nosuz/PDP-8_IM6100/IM6100/IM6100.kicad_pcb

## KiCad design IM6100/IM6100.kicad_pcb (2025-11-16)

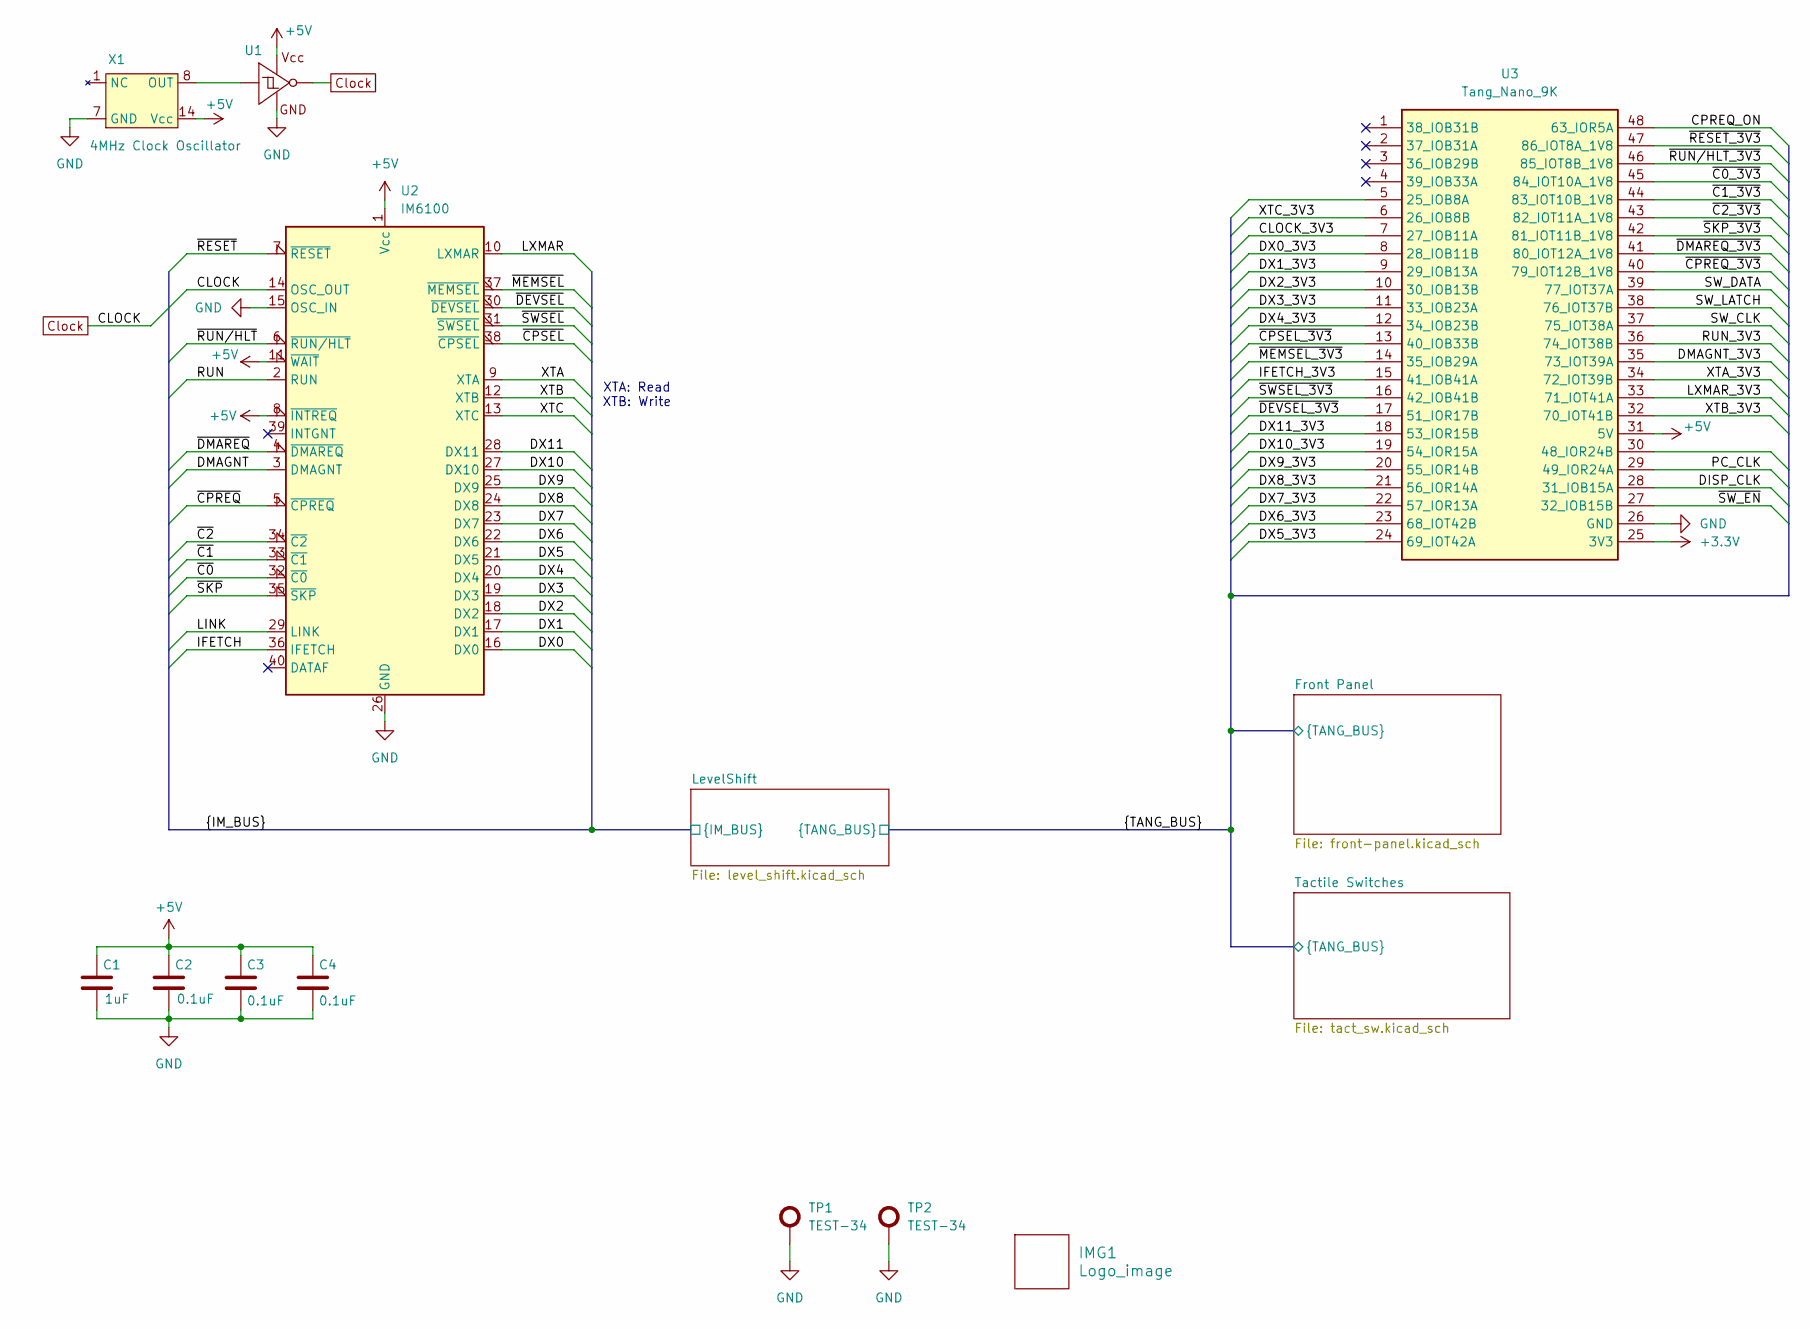
[picture p1: schematic IM6100.kicad_sch, PDP-8_IM6100]

Parts:
C1: 1uF; C_1608_0603; LCSC C15849
C2, C3, C4: 0.1uF; C_1608_0603; LCSC C14663
IMG1: Logo_image; Icon_Nosuz
TP1, TP2: TEST-34
U1: SN74AHCT1G14DBV; SOT-23-5_TI; LCSC C55250
U2: IM6100; DIP-40_IM6100
U3: Tang_Nano_9K; DIP-48_TangNano9K
X1: 4MHz Clock Oscillator; DIP-14_ClockOscillator

Connections:
+3.3V: U3.25 (3V3); also elsewhere on the board
+5V: C1.1, C2.1, C3.1, C4.1, U1.5 (Vcc), U2.1 (Vcc), U2.8 (~INTREQ), U2.11 (~WAIT), U3.31 (5V), X1.11 (Vcc), X1.14 (Vcc); also elsewhere on the board
/CLOCK_3V3: U3.7 (27_IOB11A); also elsewhere on the board
/CPREQ_ON: U3.48 (63_IOR5A); also elsewhere on the board
/DISP_CLK: U3.28 (31_IOB15A); also elsewhere on the board
/DMAGNT: U2.3 (DMAGNT); also elsewhere on the board
/DMAGNT_3V3: U3.35 (73_IOT39A); also elsewhere on the board
/DX0: U2.16 (DX0); also elsewhere on the board
/DX0_3V3: U3.8 (28_IOB11B); also elsewhere on the board
/DX1: U2.17 (DX1); also elsewhere on the board
/DX1_3V3: U3.9 (29_IOB13A); also elsewhere on the board
/DX2: U2.18 (DX2); also elsewhere on the board
/DX2_3V3: U3.10 (30_IOB13B); also elsewhere on the board
/DX3: U2.19 (DX3); also elsewhere on the board
/DX3_3V3: U3.11 (33_IOB23A); also elsewhere on the board
/DX4: U2.20 (DX4); also elsewhere on the board
/DX4_3V3: U3.12 (34_IOB23B); also elsewhere on the board
/DX5: U2.21 (DX5); also elsewhere on the board
/DX5_3V3: U3.24 (69_IOT42A); also elsewhere on the board
/DX6: U2.22 (DX6); also elsewhere on the board
/DX6_3V3: U3.23 (68_IOT42B); also elsewhere on the board
/DX7: U2.23 (DX7); also elsewhere on the board
/DX7_3V3: U3.22 (57_IOR13A); also elsewhere on the board
/DX8: U2.24 (DX8); also elsewhere on the board
/DX8_3V3: U3.21 (56_IOR14A); also elsewhere on the board
/DX9: U2.25 (DX9); also elsewhere on the board
/DX9_3V3: U3.20 (55_IOR14B); also elsewhere on the board
/DX10: U2.27 (DX10); also elsewhere on the board
/DX10_3V3: U3.19 (54_IOR15A); also elsewhere on the board
/DX11: U2.28 (DX11); also elsewhere on the board
/DX11_3V3: U3.18 (53_IOR15B); also elsewhere on the board
/IFETCH: U2.36 (IFETCH); also elsewhere on the board
/IFETCH_3V3: U3.15 (41_IOB41A); also elsewhere on the board
/LINK: U2.29 (LINK); also elsewhere on the board
/LXMAR: U2.10 (LXMAR); also elsewhere on the board
/LXMAR_3V3: U3.33 (71_IOT41A); also elsewhere on the board
/PC_CLK: U3.29 (49_IOR24A); also elsewhere on the board
/RUN: U2.2 (RUN); also elsewhere on the board
/RUN_3V3: U3.36 (74_IOT38B); also elsewhere on the board
/SW_CLK: U3.37 (75_IOT38A); also elsewhere on the board
/SW_DATA: U3.39 (77_IOT37A); also elsewhere on the board
/SW_LATCH: U3.38 (76_IOT37B); also elsewhere on the board
/XTA: U2.9 (XTA); also elsewhere on the board
/XTA_3V3: U3.34 (72_IOT39B); also elsewhere on the board
/XTB: U2.12 (XTB); also elsewhere on the board
/XTB_3V3: U3.32 (70_IOT41B); also elsewhere on the board
/XTC: U2.13 (XTC); also elsewhere on the board
/XTC_3V3: U3.6 (26_IOB8B); also elsewhere on the board
/~C0_3V3: U3.45 (84_IOT10A_1V8); also elsewhere on the board
/~C0: U2.32 (~C0); also elsewhere on the board
/~C1_3V3: U3.44 (83_IOT10B_1V8); also elsewhere on the board
/~C1: U2.33 (~C1); also elsewhere on the board
/~C2_3V3: U3.43 (82_IOT11A_1V8); also elsewhere on the board
/~C2: U2.34 (~C2); also elsewhere on the board
/~CPREQ_3V3: U3.40 (79_IOT12B_1V8); also elsewhere on the board
/~CPREQ: U2.5 (~CPREQ); also elsewhere on the board
/~CPSEL_3V3: U3.13 (40_IOB33B); also elsewhere on the board
/~CPSEL: U2.38 (~CPSEL); also elsewhere on the board
/~DEVSEL_3V3: U3.17 (51_IOR17B); also elsewhere on the board
/~DEVSEL: U2.30 (~DEVSEL); also elsewhere on the board
/~DMAREQ_3V3: U3.41 (80_IOT12A_1V8); also elsewhere on the board
/~DMAREQ: U2.4 (~DMAREQ); also elsewhere on the board
/~MEMSEL_3V3: U3.14 (35_IOB29A); also elsewhere on the board
/~MEMSEL: U2.37 (~MEMSEL); also elsewhere on the board
/~RESET_3V3: U3.47 (86_IOT8A_1V8); also elsewhere on the board
/~RESET: U2.7 (~RESET); also elsewhere on the board
/~RUN/HLT_3V3: U3.46 (85_IOT8B_1V8); also elsewhere on the board
/~RUN/HLT: U2.6 (~RUN/HLT); also elsewhere on the board
/~SKP_3V3: U3.42 (81_IOT11B_1V8); also elsewhere on the board
/~SKP: U2.35 (~SKP); also elsewhere on the board
/~SWSEL_3V3: U3.16 (42_IOB41B); also elsewhere on the board
/~SWSEL: U2.31 (~SWSEL); also elsewhere on the board
/~SW_EN: U3.27 (32_IOB15B); also elsewhere on the board
Clock: U1.4 (Y), U2.14 (OSC_OUT); also elsewhere on the board
GND: C1.2, C2.2, C3.2, C4.2, TP1.1 (Test), TP2.1 (Test), U1.3 (GND), U2.15 (OSC_IN), U2.26 (GND), U3.26 (GND), X1.2 (GND), X1.3 (GND), X1.5 (GND), X1.6 (GND), X1.7 (GND), X1.9 (GND), X1.10 (GND), X1.12 (GND), X1.13 (GND); also elsewhere on the board
unnamed: U1.2 (A), X1.8 (OUT)

Notes on the sheet:
XTA: Read XTB: Write

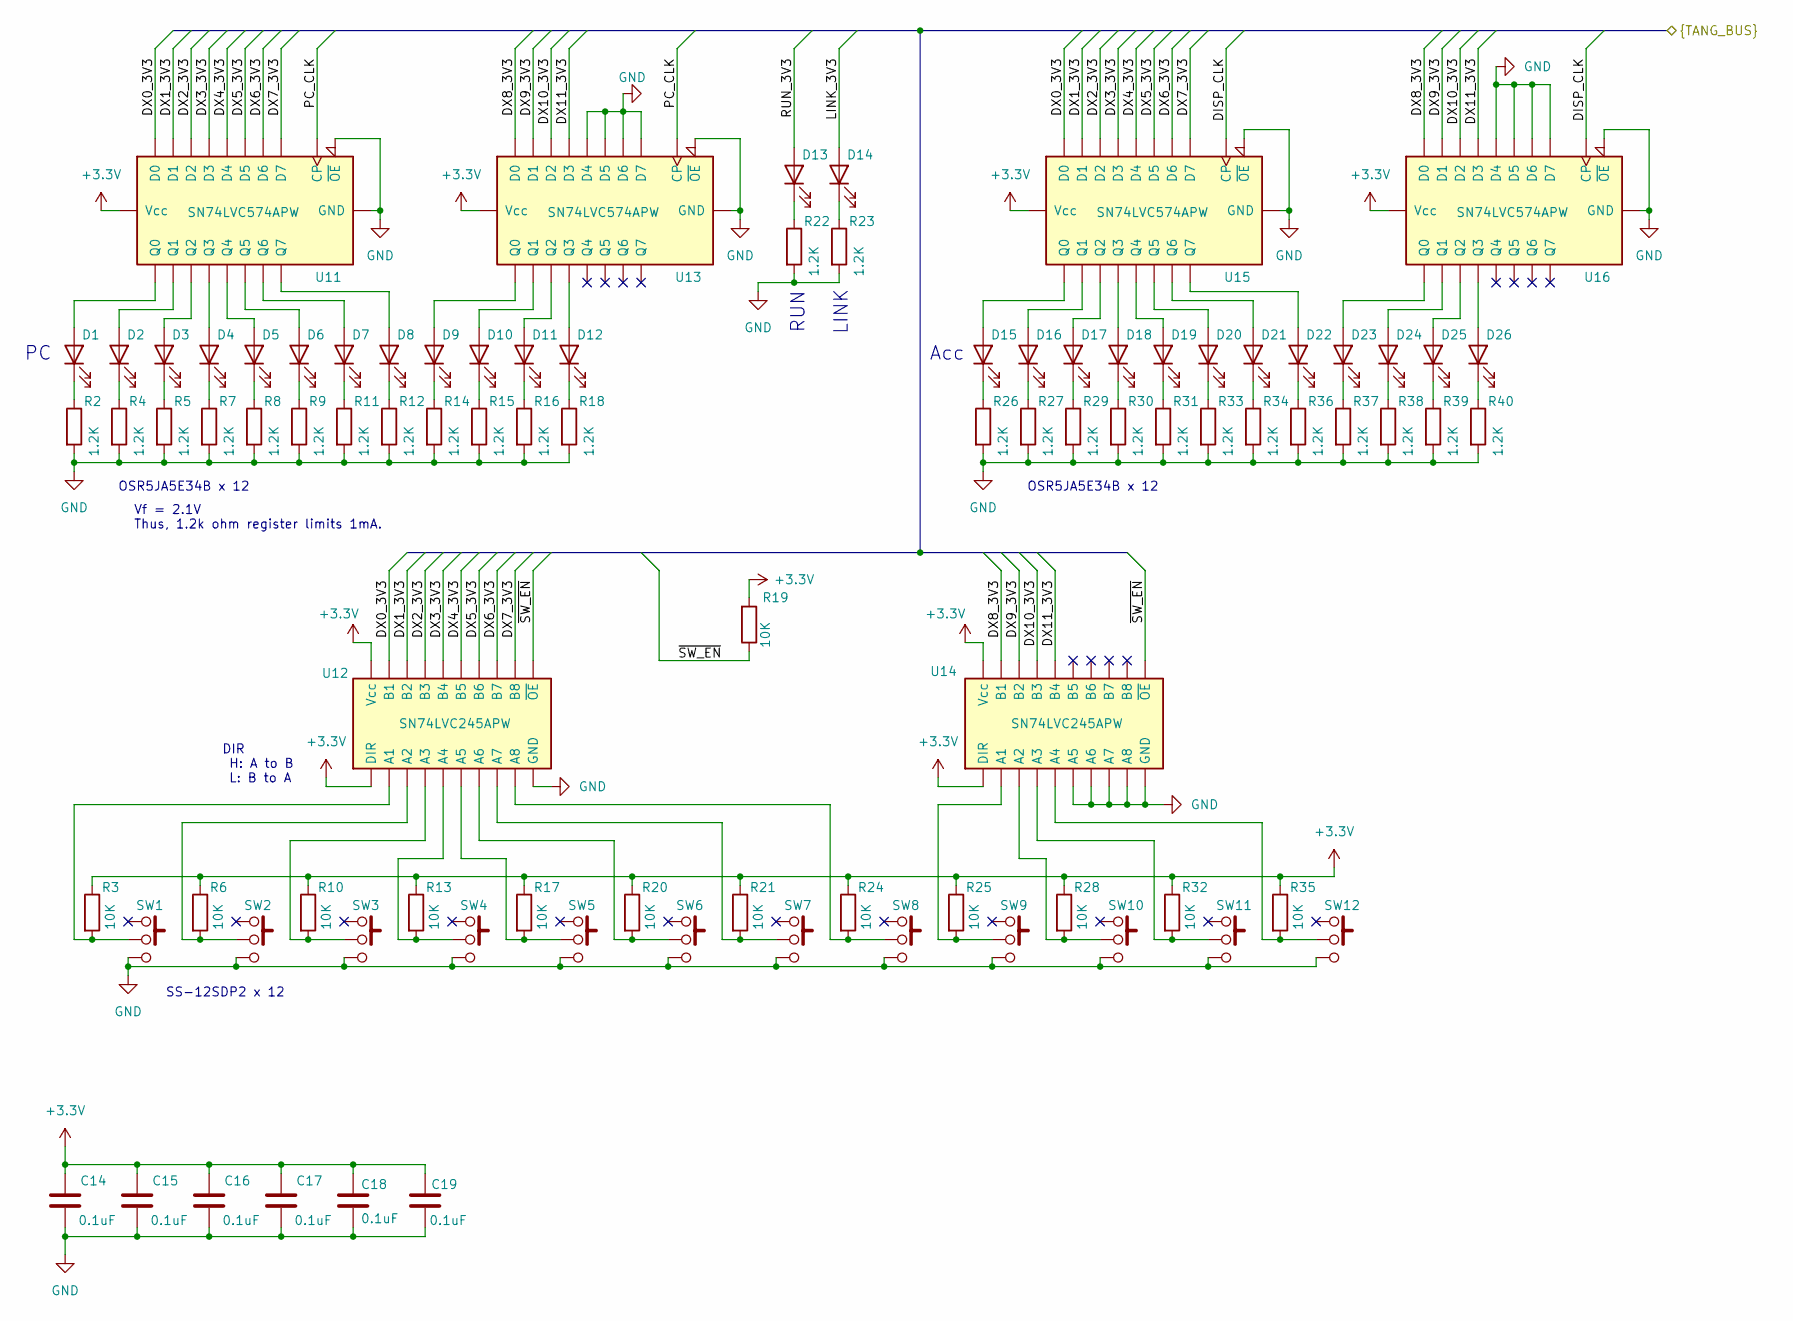
[picture p2: schematic front-panel.kicad_sch, PDP-8_IM6100]

Parts:
C14, C15, C16, C17, C18, C19: 0.1uF; C_1608_0603; LCSC C14663
D1, D2, D3, D4, D5, D6, D7, D8, D9, D10, D11, D12, D13, D14, D15, D16, D17, D18, D19, D20, D21, D22, D23, D24, D25, D26: OSR5JA5E34B; LED_5mm
R2, R4, R5, R7, R8, R9, R11, R12, R14, R15, R16, R18, R22, R23, R26, R27, R29, R30, R31, R33, R34, R36, R37, R38, R39, R40: 1.2K; R_1608_0603; LCSC C22765
R3, R6, R10, R13, R17, R19, R20, R21, R24, R25, R28, R32, R35: 10K; R_1608_0603; LCSC C25804
SW1, SW2, SW3, SW4, SW5, SW6, SW7, SW8, SW9, SW10, SW11, SW12: SS-12SDP2
U11, U13, U15, U16: SN74LVC574APW; TSSOP-20_TI-PW; LCSC C7672
U12, U14: SN74LVC245APW; TSSOP-20_TI-PW; LCSC C7848

Connections:
+3.3V: C14.1, C15.1, C16.1, C17.1, C18.1, C19.1, R3.1, R6.1, R10.1, R13.1, R17.1, R19.2, R20.1, R21.1, R24.1, R25.1, R28.1, R32.1, R35.1, U11.20 (Vcc), U12.1 (DIR), U12.20 (Vcc), U13.20 (Vcc), U14.1 (DIR), U14.20 (Vcc), U15.20 (Vcc), U16.20 (Vcc); also elsewhere on the board
/DISP_CLK: U15.11 (CP), U16.11 (CP); also elsewhere on the board
/DX0_3V3: U11.2 (D0), U12.18 (B1), U15.2 (D0); also elsewhere on the board
/DX1_3V3: U11.3 (D1), U12.17 (B2), U15.3 (D1); also elsewhere on the board
/DX2_3V3: U11.4 (D2), U12.16 (B3), U15.4 (D2); also elsewhere on the board
/DX3_3V3: U11.5 (D3), U12.15 (B4), U15.5 (D3); also elsewhere on the board
/DX4_3V3: U11.6 (D4), U12.14 (B5), U15.6 (D4); also elsewhere on the board
/DX5_3V3: U11.7 (D5), U12.13 (B6), U15.7 (D5); also elsewhere on the board
/DX6_3V3: U11.8 (D6), U12.12 (B7), U15.8 (D6); also elsewhere on the board
/DX7_3V3: U11.9 (D7), U12.11 (B8), U15.9 (D7); also elsewhere on the board
/DX8_3V3: U13.2 (D0), U14.18 (B1), U16.2 (D0); also elsewhere on the board
/DX9_3V3: U13.3 (D1), U14.17 (B2), U16.3 (D1); also elsewhere on the board
/DX10_3V3: U13.4 (D2), U14.16 (B3), U16.4 (D2); also elsewhere on the board
/DX11_3V3: U13.5 (D3), U14.15 (B4), U16.5 (D3); also elsewhere on the board
/LINK_3V3: D14.2 (A); also elsewhere on the board
/PC_CLK: U11.11 (CP), U13.11 (CP); also elsewhere on the board
/RUN_3V3: D13.2 (A); also elsewhere on the board
/~SW_EN: R19.1, U12.19 (~OE), U14.19 (~OE); also elsewhere on the board
GND: C14.2, C15.2, C16.2, C17.2, C18.2, C19.2, R2.2, R4.2, R5.2, R7.2, R8.2, R9.2, R11.2, R12.2, R14.2, R15.2, R16.2, R18.2, R22.2, R23.2, R26.2, R27.2, R29.2, R30.2, R31.2, R33.2, R34.2, R36.2, R37.2, R38.2, R39.2, R40.2, SW1.1, SW2.1, SW3.1, SW4.1, SW5.1, SW6.1, SW7.1, SW8.1, SW9.1, SW10.1, SW11.1, SW12.1, U11.1 (~OE), U11.10 (GND), U12.10 (GND), U13.1 (~OE), U13.6 (D4), U13.7 (D5), U13.8 (D6), U13.9 (D7), U13.10 (GND), U14.6 (A5), U14.7 (A6), U14.8 (A7), U14.9 (A8), U14.10 (GND), U15.1 (~OE), U15.10 (GND), U16.1 (~OE), U16.6 (D4), U16.7 (D5), U16.8 (D6), U16.9 (D7), U16.10 (GND); also elsewhere on the board
unnamed: D1.2 (A), U11.19 (Q0)
unnamed: D1.1 (K), R2.1
unnamed: D2.2 (A), U11.18 (Q1)
unnamed: D2.1 (K), R4.1
unnamed: D3.2 (A), U11.17 (Q2)
unnamed: D3.1 (K), R5.1
unnamed: D4.2 (A), U11.16 (Q3)
unnamed: D4.1 (K), R7.1
unnamed: D5.2 (A), U11.15 (Q4)
unnamed: D5.1 (K), R8.1
unnamed: D6.2 (A), U11.14 (Q5)
unnamed: D6.1 (K), R9.1
unnamed: D7.2 (A), U11.13 (Q6)
unnamed: D7.1 (K), R11.1
unnamed: D8.2 (A), U11.12 (Q7)
unnamed: D8.1 (K), R12.1
unnamed: D9.2 (A), U13.19 (Q0)
unnamed: D9.1 (K), R14.1
unnamed: D10.2 (A), U13.18 (Q1)
unnamed: D10.1 (K), R15.1
unnamed: D11.2 (A), U13.17 (Q2)
unnamed: D11.1 (K), R16.1
unnamed: D12.2 (A), U13.16 (Q3)
unnamed: D12.1 (K), R18.1
unnamed: D13.1 (K), R22.1
unnamed: D14.1 (K), R23.1
unnamed: D15.2 (A), U15.19 (Q0)
unnamed: D15.1 (K), R26.1
unnamed: D16.2 (A), U15.18 (Q1)
unnamed: D16.1 (K), R27.1
unnamed: D17.2 (A), U15.17 (Q2)
unnamed: D17.1 (K), R29.1
unnamed: D18.2 (A), U15.16 (Q3)
unnamed: D18.1 (K), R30.1
unnamed: D19.2 (A), U15.15 (Q4)
unnamed: D19.1 (K), R31.1
unnamed: D20.2 (A), U15.14 (Q5)
unnamed: D20.1 (K), R33.1
unnamed: D21.2 (A), U15.13 (Q6)
unnamed: D21.1 (K), R34.1
unnamed: D22.2 (A), U15.12 (Q7)
unnamed: D22.1 (K), R36.1
unnamed: D23.2 (A), U16.19 (Q0)
unnamed: D23.1 (K), R37.1
unnamed: D24.2 (A), U16.18 (Q1)
unnamed: D24.1 (K), R38.1
unnamed: D25.2 (A), U16.17 (Q2)
unnamed: D25.1 (K), R39.1
unnamed: D26.2 (A), U16.16 (Q3)
unnamed: D26.1 (K), R40.1
unnamed: R3.2, SW1.2, U12.2 (A1)
unnamed: R6.2, SW2.2, U12.3 (A2)
unnamed: R10.2, SW3.2, U12.4 (A3)
unnamed: R13.2, SW4.2, U12.5 (A4)
unnamed: R17.2, SW5.2, U12.6 (A5)
unnamed: R20.2, SW6.2, U12.7 (A6)
unnamed: R21.2, SW7.2, U12.8 (A7)
unnamed: R24.2, SW8.2, U12.9 (A8)
unnamed: R25.2, SW9.2, U14.2 (A1)
unnamed: R28.2, SW10.2, U14.3 (A2)
unnamed: R32.2, SW11.2, U14.4 (A3)
unnamed: R35.2, SW12.2, U14.5 (A4)

Notes on the sheet:
OSR5JA5E34B x 12
SS-12SDP2 x 12
Vf = 2.1V Thus, 1.2k ohm register limits 1mA.
LINK
DIR H: A to B L: B to A
RUN
Acc

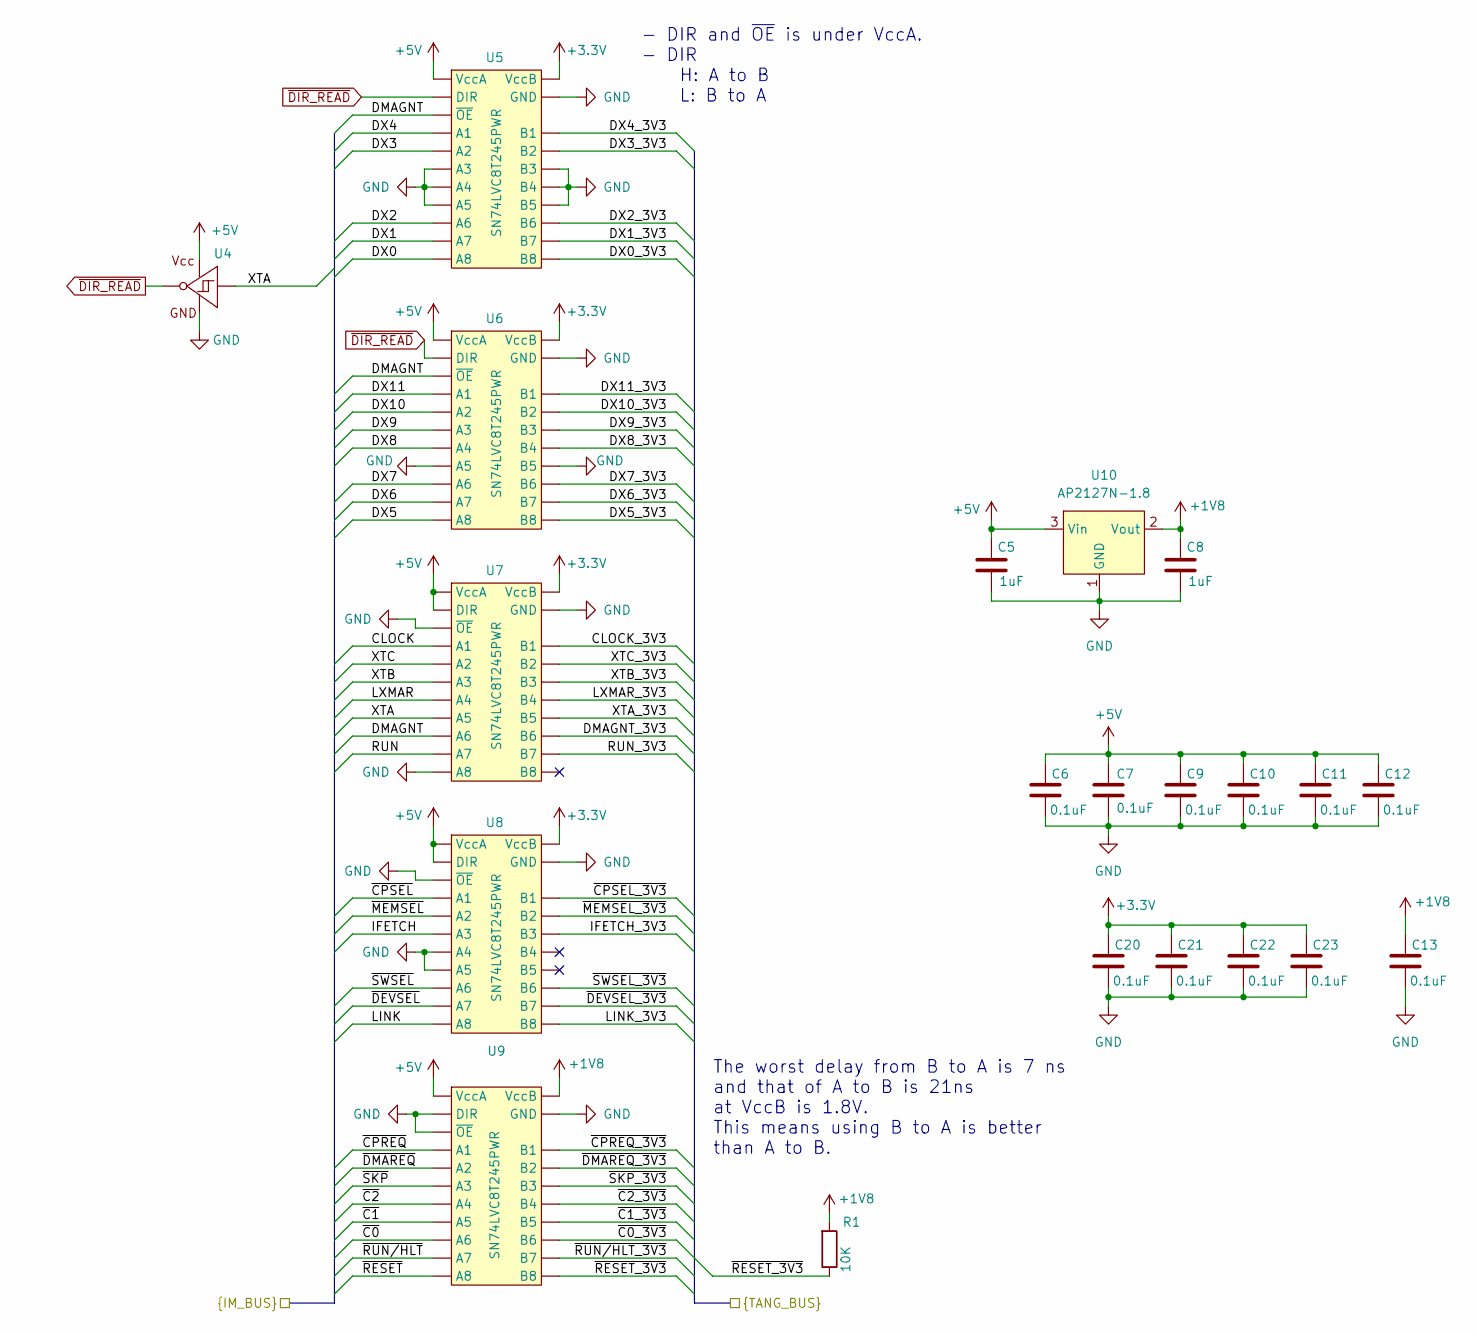
[picture p3: schematic level_shift.kicad_sch, PDP-8_IM6100]

Parts:
C5, C8: 1uF; C_1608_0603; LCSC C15849
C6, C7, C9, C10, C11, C12, C13, C20, C21, C22, C23: 0.1uF; C_1608_0603; LCSC C14663
R1: 10K; R_1608_0603; LCSC C25804
U4: SN74AHCT1G14DBV; SOT-23-5_TI; LCSC C55250
U5, U6, U7, U8, U9: SN74LVC8T245PWR; TSSOP-24_TI-PW; LCSC C27643
U10: AP2127N-1.8; SOT-23_AP2127N; LCSC C780749

Connections:
+1V8: C8.1, C13.1, R1.2, U9.23 (VccB), U9.24 (VccB), U10.2 (Vout)
+3.3V: C20.1, C21.1, C22.1, C23.1, U5.23 (VccB), U5.24 (VccB), U6.23 (VccB), U6.24 (VccB), U7.23 (VccB), U7.24 (VccB), U8.23 (VccB), U8.24 (VccB); also elsewhere on the board
+5V: C5.1, C6.1, C7.1, C9.1, C10.1, C11.1, C12.1, U4.5 (Vcc), U5.1 (VccA), U6.1 (VccA), U7.1 (VccA), U7.2 (DIR), U8.1 (VccA), U8.2 (DIR), U9.1 (VccA), U10.3 (Vin); also elsewhere on the board
/CLOCK_3V3: U7.21 (B1); also elsewhere on the board
/DMAGNT: U5.22 (~OE), U6.22 (~OE), U7.8 (A6); also elsewhere on the board
/DMAGNT_3V3: U7.16 (B6); also elsewhere on the board
/DX0: U5.10 (A8); also elsewhere on the board
/DX0_3V3: U5.14 (B8); also elsewhere on the board
/DX1: U5.9 (A7); also elsewhere on the board
/DX1_3V3: U5.15 (B7); also elsewhere on the board
/DX2: U5.8 (A6); also elsewhere on the board
/DX2_3V3: U5.16 (B6); also elsewhere on the board
/DX3: U5.4 (A2); also elsewhere on the board
/DX3_3V3: U5.20 (B2); also elsewhere on the board
/DX4: U5.3 (A1); also elsewhere on the board
/DX4_3V3: U5.21 (B1); also elsewhere on the board
/DX5: U6.10 (A8); also elsewhere on the board
/DX5_3V3: U6.14 (B8); also elsewhere on the board
/DX6: U6.9 (A7); also elsewhere on the board
/DX6_3V3: U6.15 (B7); also elsewhere on the board
/DX7: U6.8 (A6); also elsewhere on the board
/DX7_3V3: U6.16 (B6); also elsewhere on the board
/DX8: U6.6 (A4); also elsewhere on the board
/DX8_3V3: U6.18 (B4); also elsewhere on the board
/DX9: U6.5 (A3); also elsewhere on the board
/DX9_3V3: U6.19 (B3); also elsewhere on the board
/DX10: U6.4 (A2); also elsewhere on the board
/DX10_3V3: U6.20 (B2); also elsewhere on the board
/DX11: U6.3 (A1); also elsewhere on the board
/DX11_3V3: U6.21 (B1); also elsewhere on the board
/IFETCH: U8.5 (A3); also elsewhere on the board
/IFETCH_3V3: U8.19 (B3); also elsewhere on the board
/LINK: U8.10 (A8); also elsewhere on the board
/LINK_3V3: U8.14 (B8); also elsewhere on the board
/LXMAR: U7.6 (A4); also elsewhere on the board
/LXMAR_3V3: U7.18 (B4); also elsewhere on the board
/RUN: U7.9 (A7); also elsewhere on the board
/RUN_3V3: U7.15 (B7); also elsewhere on the board
/XTA: U4.2 (A), U7.7 (A5); also elsewhere on the board
/XTA_3V3: U7.17 (B5); also elsewhere on the board
/XTB: U7.5 (A3); also elsewhere on the board
/XTB_3V3: U7.19 (B3); also elsewhere on the board
/XTC: U7.4 (A2); also elsewhere on the board
/XTC_3V3: U7.20 (B2); also elsewhere on the board
/~C0_3V3: U9.16 (B6); also elsewhere on the board
/~C0: U9.8 (A6); also elsewhere on the board
/~C1_3V3: U9.17 (B5); also elsewhere on the board
/~C1: U9.7 (A5); also elsewhere on the board
/~C2_3V3: U9.18 (B4); also elsewhere on the board
/~C2: U9.6 (A4); also elsewhere on the board
/~CPREQ_3V3: U9.21 (B1); also elsewhere on the board
/~CPREQ: U9.3 (A1); also elsewhere on the board
/~CPSEL_3V3: U8.21 (B1); also elsewhere on the board
/~CPSEL: U8.3 (A1); also elsewhere on the board
/~DEVSEL_3V3: U8.15 (B7); also elsewhere on the board
/~DEVSEL: U8.9 (A7); also elsewhere on the board
/~DMAREQ_3V3: U9.20 (B2); also elsewhere on the board
/~DMAREQ: U9.4 (A2); also elsewhere on the board
/~MEMSEL_3V3: U8.20 (B2); also elsewhere on the board
/~MEMSEL: U8.4 (A2); also elsewhere on the board
/~RESET_3V3: R1.1, U9.14 (B8); also elsewhere on the board
/~RESET: U9.10 (A8); also elsewhere on the board
/~RUN/HLT_3V3: U9.15 (B7); also elsewhere on the board
/~RUN/HLT: U9.9 (A7); also elsewhere on the board
/~SKP_3V3: U9.19 (B3); also elsewhere on the board
/~SKP: U9.5 (A3); also elsewhere on the board
/~SWSEL_3V3: U8.16 (B6); also elsewhere on the board
/~SWSEL: U8.8 (A6); also elsewhere on the board
Clock: U7.3 (A1); also elsewhere on the board
GND: C5.2, C6.2, C7.2, C8.2, C9.2, C10.2, C11.2, C12.2, C13.2, C20.2, C21.2, C22.2, C23.2, U4.3 (GND), U5.5 (A3), U5.6 (A4), U5.7 (A5), U5.11 (GND), U5.12 (GND), U5.13 (GND), U5.17 (B5), U5.18 (B4), U5.19 (B3), U6.7 (A5), U6.11 (GND), U6.12 (GND), U6.13 (GND), U6.17 (B5), U7.10 (A8), U7.11 (GND), U7.12 (GND), U7.13 (GND), U7.22 (~OE), U8.6 (A4), U8.7 (A5), U8.11 (GND), U8.12 (GND), U8.13 (GND), U8.22 (~OE), U9.2 (DIR), U9.11 (GND), U9.12 (GND), U9.13 (GND), U9.22 (~OE), U10.1 (GND); also elsewhere on the board
~DIR_READ: U4.4 (Y), U5.2 (DIR), U6.2 (DIR)

Notes on the sheet:
The worst delay from B to A is 7 ns and that of A to B is 21ns at VccB is 1.8V. This means using B to A is better than A to B.
- DIR and ~{OE} is under VccA. - DIR H: A to B L: B to A

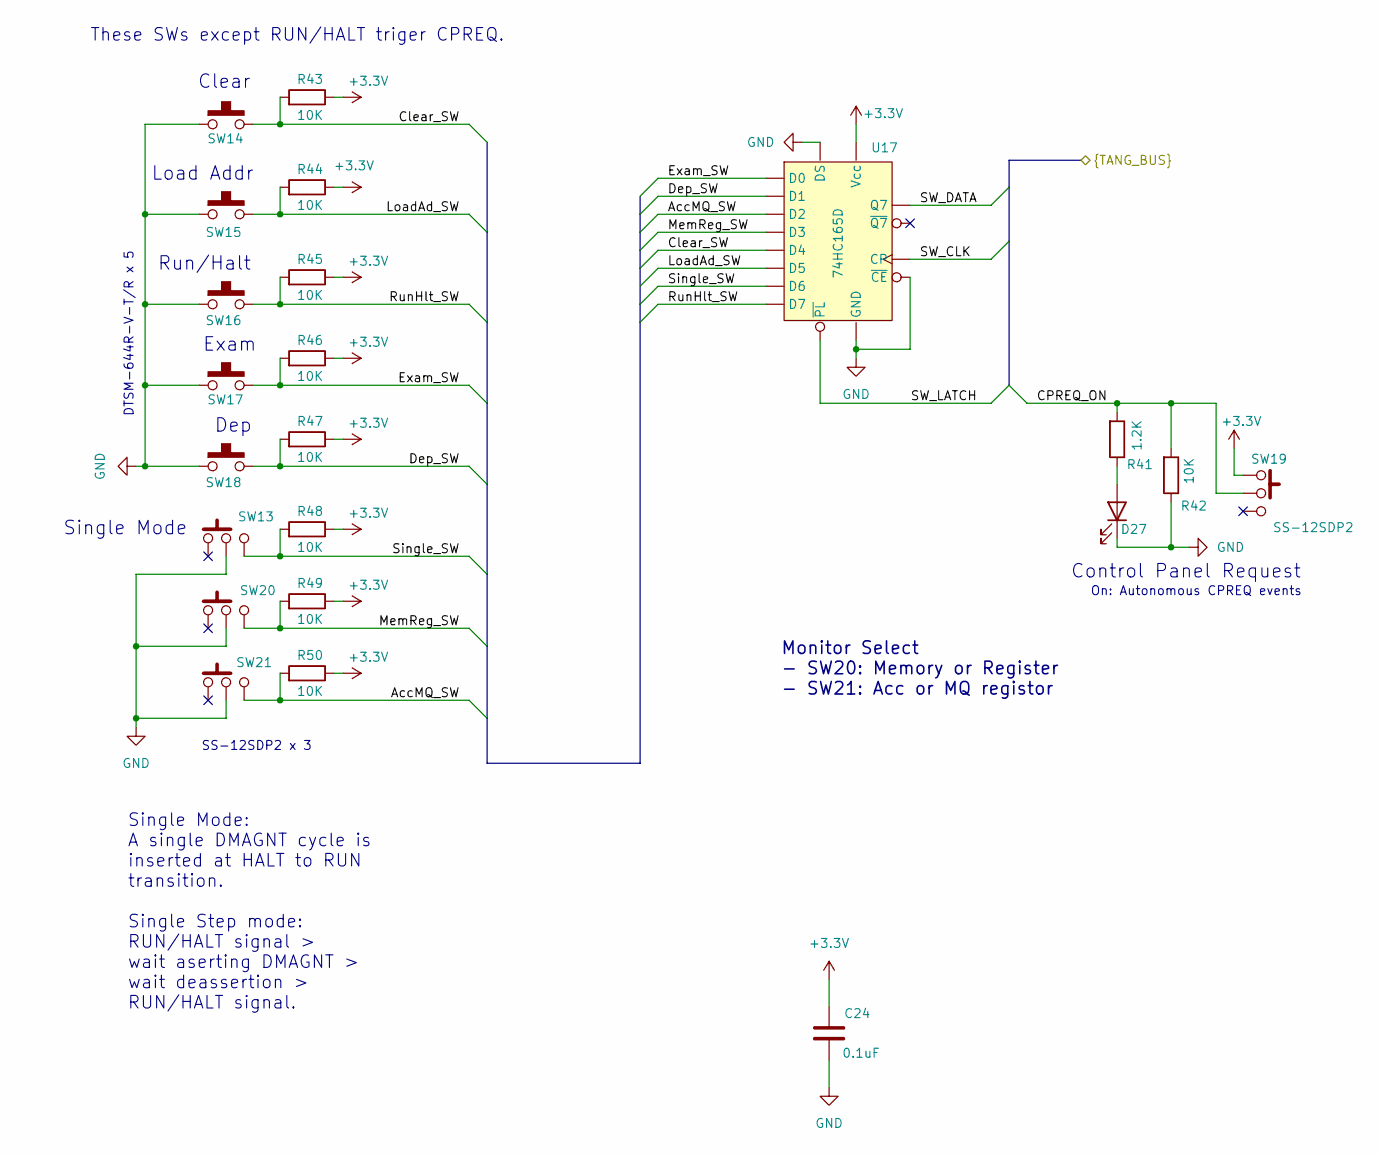
[picture p4: schematic tact_sw.kicad_sch, PDP-8_IM6100]

Parts:
C24: 0.1uF; C_1608_0603; LCSC C14663
D27: OSR5JA5E34B; LED_5mm
R41: 1.2K; R_1608_0603; LCSC C22765
R42, R43, R44, R45, R46, R47, R48, R49, R50: 10K; R_1608_0603; LCSC C25804
SW13, SW19, SW20, SW21: SS-12SDP2
SW14, SW15, SW16, SW17, SW18: DTSM-63N-V-T/R; DTSM-6x; LCSC C133973
U17: 74HC165D; SOIC-16_3.9x9.9mm_P1.27mm; LCSC C5613

Connections:
+3.3V: C24.1, R43.1, R44.1, R45.1, R46.1, R47.1, R48.1, R49.1, R50.1, SW19.3, U17.16 (Vcc); also elsewhere on the board
/CPREQ_ON: R41.2, R42.2, SW19.2; also elsewhere on the board
/SW_CLK: U17.2 (CP); also elsewhere on the board
/SW_DATA: U17.9 (Q7); also elsewhere on the board
/SW_LATCH: U17.1 (~PL); also elsewhere on the board
/Tactile Switches/AccMQ_SW: R50.2, SW21.1, U17.13 (D2)
/Tactile Switches/Clear_SW: R43.2, SW14.3 (C), SW14.4 (D), U17.3 (D4)
/Tactile Switches/Dep_SW: R47.2, SW18.3 (C), SW18.4 (D), U17.12 (D1)
/Tactile Switches/Exam_SW: R46.2, SW17.3 (C), SW17.4 (D), U17.11 (D0)
/Tactile Switches/LoadAd_SW: R44.2, SW15.3 (C), SW15.4 (D), U17.4 (D5)
/Tactile Switches/MemReg_SW: R49.2, SW20.1, U17.14 (D3)
/Tactile Switches/RunHlt_SW: R45.2, SW16.3 (C), SW16.4 (D), U17.6 (D7)
/Tactile Switches/Single_SW: R48.2, SW13.1, U17.5 (D6)
GND: C24.2, D27.1 (K), R42.1, SW13.2, SW14.1 (A), SW14.2 (B), SW15.1 (A), SW15.2 (B), SW16.1 (A), SW16.2 (B), SW17.1 (A), SW17.2 (B), SW18.1 (A), SW18.2 (B), SW20.2, SW21.2, U17.8 (GND), U17.10 (DS), U17.15 (~CE); also elsewhere on the board
unnamed: D27.2 (A), R41.1

Notes on the sheet:
Load Addr
Single Mode
Run/Halt
Dep
Single Mode: A single DMAGNT cycle is inserted at HALT to RUN transition. Single Step mode: RUN/HALT signal > wait aserting DMAGNT > wait deassertion > RUN/HALT signal.
Clear
Control Panel Request
Monitor Select - SW20: Memory or Register - SW21: Acc or MQ registor
These SWs except RUN/HALT triger CPREQ.
SS-12SDP2 x 3
DTSM-644R-V-T/R x 5
On: Autonomous CPREQ events
Exam

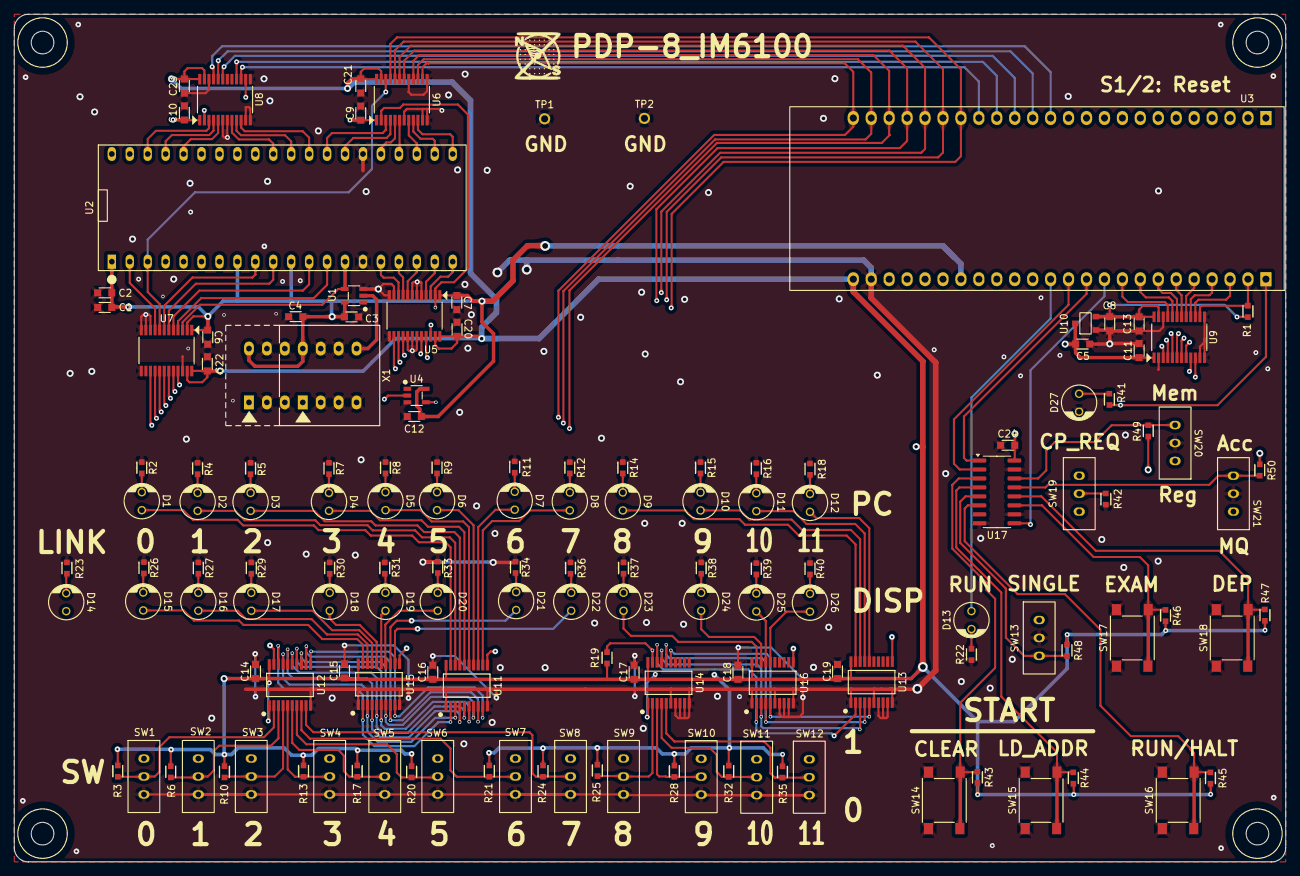
[picture p5: board IM6100.kicad_pcb from above]

Board: 4 copper layers, 180.0 x 120.0 mm, 143 parts (0 on the bottom side), 150 nets.
