nosuz/PDP-8_IM6100/TangNano9K/board_test/src/gowin_osc/gowin_osc.v

//Copyright (C)2014-2025 Gowin Semiconductor Corporation.
//All rights reserved.
//File Title: IP file
//Tool Version: V1.9.12 (64-bit)
//Part Number: GW1NR-LV9QN88PC6/I5
//Device: GW1NR-9
//Device Version: C
//Created Time: Mon Oct 13 15:24:38 2025

module Gowin_OSC (oscout);

output oscout;

OSC osc_inst (
    .OSCOUT(oscout)
);

defparam osc_inst.FREQ_DIV = 100;
defparam osc_inst.DEVICE = "GW1NR-9C";

endmodule //Gowin_OSC
