nosuz/PDP-8_IM6100/(commit log)

2025-09-10 Created KiCad project.
    [IM6100.kicad_pcb, IM6100.kicad_sch]
2025-09-11 Updated .gitignore to ignore Libreoffice and KiCad crash backup files.
2025-09-13 Updated symbol and footprint module.
2025-09-14 PCB for IM6100, PDP-8 ISA compatible 12 bit microprocessor.
    [IM6100.kicad_pcb, IM6100.kicad_sch, bom.csv, front-panel.kicad_sch, positions.csv]
2025-09-14 Removed Pull-dow on ~RESET.
    TXB0108 can't use pull-up and -down.
    [IM6100.kicad_pcb, IM6100.kicad_sch, bom.csv, positions.csv]
2025-09-14 Fixed to reset IM6100 during setting up Tang Nano 9K.
    [IM6100.kicad_pcb, IM6100.kicad_sch, bom.csv, positions.csv]
2025-09-14 Updated tactile switch.
    [IM6100.kicad_pcb, bom.csv, front-panel.kicad_sch]
2025-09-15 Updated IC socket part number for IM6100.
    [IM6100.kicad_pcb, IM6100.kicad_sch, bom.csv]
2025-10-13 Updated BOM file.
    [bom.csv]
2025-11-16 Replaced level shifter logics to SN74LVC8T245.
    [IM6100.kicad_pcb, IM6100.kicad_sch, bom.csv, front-panel.kicad_sch, level_shift.kicad_sch, positions.csv, tact_sw.kicad_sch]
